Jeffreypir/EstatisticaEmbarcada/EstatisticaEmbarcada/Hardware/Fotos/proj1.jpeg

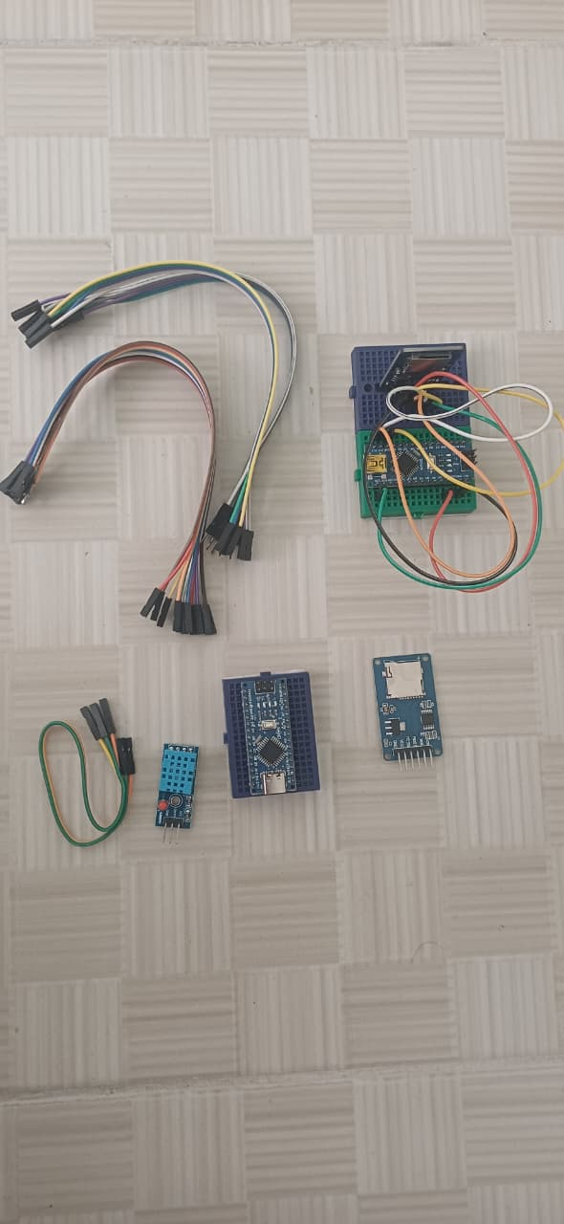
EstatisticaEmbarcada/Hardware/Fotos/proj1.jpeg
