Jeffreypir/EstatisticaEmbarcada/EstatisticaEmbarcada/Hardware/Fotos/proj2.jpeg

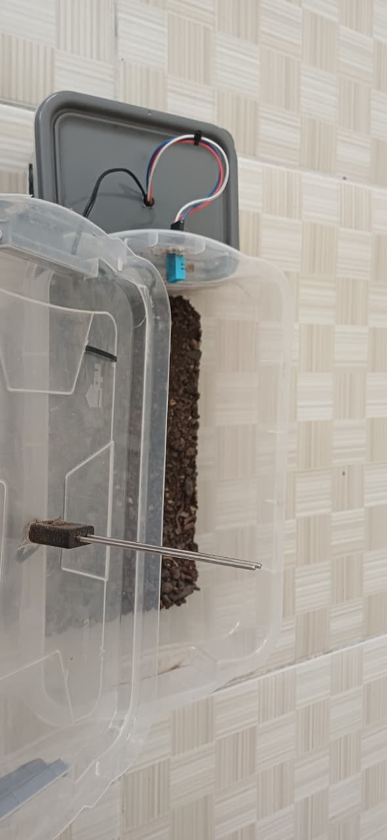
EstatisticaEmbarcada/Hardware/Fotos/proj2.jpeg
