Jeffreypir/EstatisticaEmbarcada/EstatisticaEmbarcada/Hardware/Fotos/proj3.jpeg

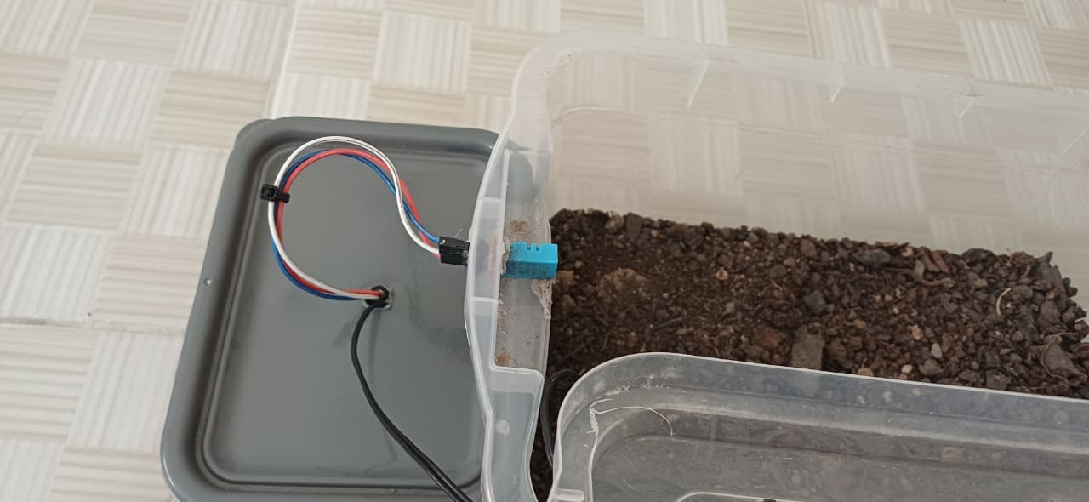
EstatisticaEmbarcada/Hardware/Fotos/proj3.jpeg
