Jeffreypir/EstatisticaEmbarcada/EstatisticaEmbarcada/Hardware/Fotos/proj4.jpeg

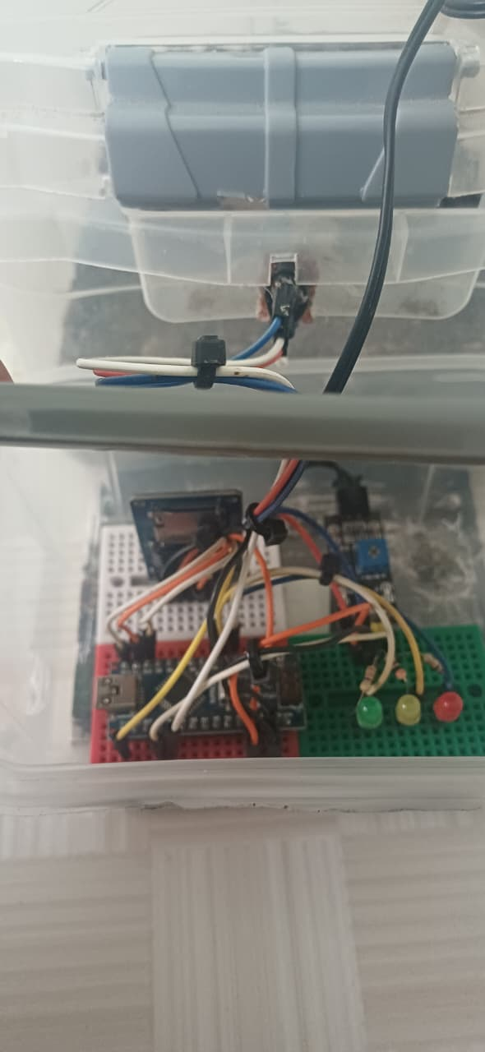
EstatisticaEmbarcada/Hardware/Fotos/proj4.jpeg
