Jeffreypir/EstatisticaEmbarcada/EstatisticaEmbarcada/Hardware/Fotos/proj5.jpeg

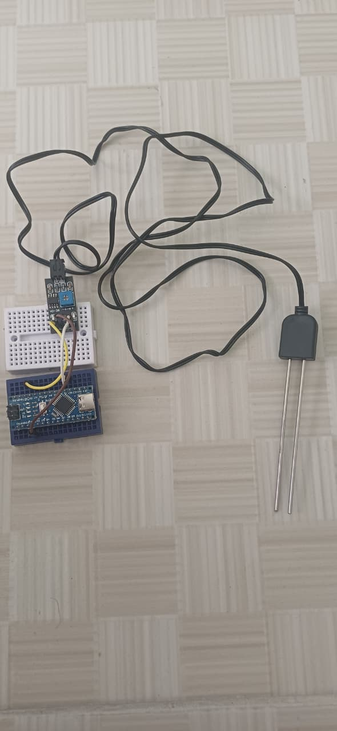
EstatisticaEmbarcada/Hardware/Fotos/proj5.jpeg
