Jeffreypir/EstatisticaEmbarcada/EstatisticaEmbarcada/Hardware/Fotos/proj6.jpeg

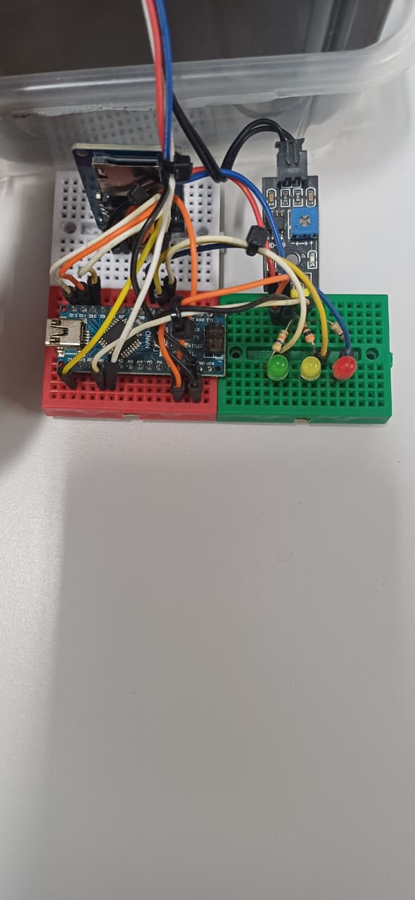
EstatisticaEmbarcada/Hardware/Fotos/proj6.jpeg
