Jeffreypir/EstatisticaEmbarcada/EstatisticaEmbarcada/Dados/Analise/resultados/07_correlacao_global/correlacao_pearson.csv

 | UmidadeAr | Temp | USolo
UmidadeAr | 1.000 | -0.417 | 0.313
Temp | -0.417 | 1.000 | 0.037
USolo | 0.313 | 0.037 | 1.000
