Jeffreypir/EstatisticaEmbarcada/EstatisticaEmbarcada/Dados/Analise/resultados/07_correlacao_global/correlacao_spearman.csv

 | UmidadeAr | Temp | USolo
UmidadeAr | 1.000 | -0.471 | 0.065
Temp | -0.471 | 1.000 | 0.028
USolo | 0.065 | 0.028 | 1.000
