Jeffreypir/EstatisticaEmbarcada/EstatisticaEmbarcada/Hardware/EsquemaEletrico/esquemaEletrico.pdf

## Datalogger ambiental Esquema elétrico com pinagem

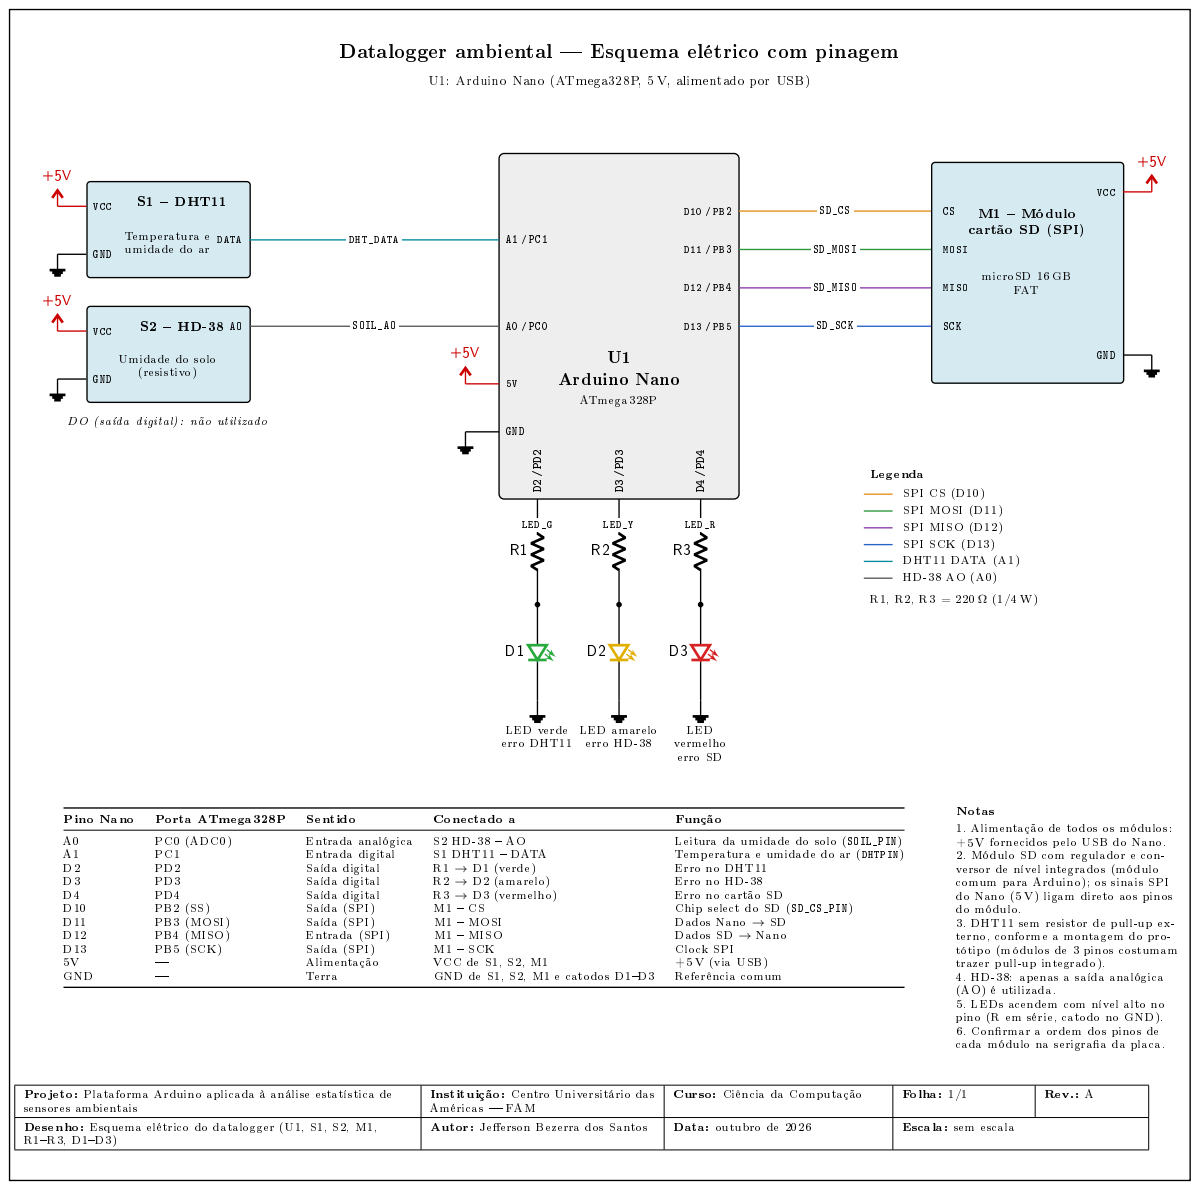
[picture p47: page 1]

U1: Arduino Nano (ATmega328P, 5 V, alimentado por USB)

DO (saída digital): não utilizado

Notas
1. Alimentação de todos os módulos:
+5 V fornecidos pelo USB do Nano.
2. Módulo SD com regulador e con-
versor de nível integrados (módulo
comum para Arduino); os sinais SPI
do Nano (5 V) ligam direto aos pinos
do módulo.
3. DHT11 sem resistor de pull-up ex-
terno, conforme a montagem do pro-
tótipo (módulos de 3 pinos costumam
trazer pull-up integrado).
4. HD-38: apenas a saída analógica
(AO) é utilizada.
5. LEDs acendem com nível alto no
pino (R em série, catodo no GND).
6. Conrmar a ordem dos pinos de
cada módulo na serigraa da placa.

Projeto: Plataforma Arduino aplicada à análise estatística de sensores ambientais | Instituição: Centro Universitário das Américas  FAM | Curso: Ciência da Computação | Folha: 1/1 | Rev.: A

Desenho: Esquema elétrico do datalogger (U1, S1, S2, M1, R1R3, D1D3) | Autor: Jeerson Bezerra dos Santos | Data: outubro de 2026 | Escala: sem escala
